openenergymonitor/emonbase/docs/rfm69-pi.md

# emonBase with RFM69Pi (ATmega328)

Version 3 of the RFM69Pi was released in 2015 and sold as part of the emonBase package until end of 2022. This product has now been replaced with the RFM69-SPI board. We do have a limited stock of the original v3 RFM69Pi board for applications that require backwards compatibility.

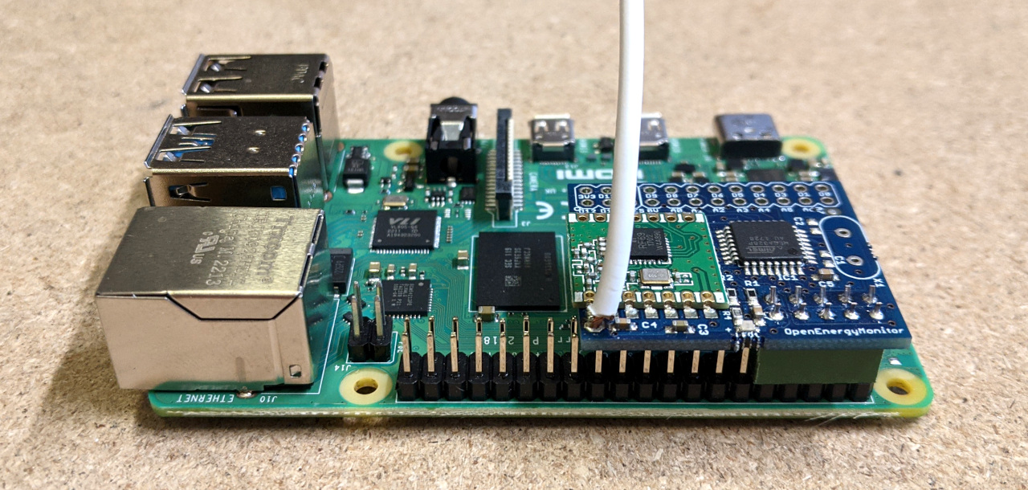
[picture p4: docs/img/emonBase_rfm69_pi.jpg]


## Using an RFM69Pi v3 with the emonTx4

If you are looking to use the new emonTx4 energy monitoring node with an existing emonBase with the RFM69Pi v3 adapter board there are a couple of options:

1\. Use the backwards compatible JeeLib Classic radio format on the emonTx4 unit. This can be selected when buying an emonTx4 form the shop.

2\. Update the firmware on the on the RFM69Pi v3 board to the LowPowerLabs compatible emonBase_rfm69pi_LPL firmware using the firmware update tool on the emonBase. Navigate to Admin > Update > Update Firmware Only. Select hardware: rfm69pi, Radio format: RFM69 LowPowerLabs.



## Firmware

- [emonBase_rfm69pi](https://github.com/openenergymonitor/RFM2Pi/tree/master/firmware/emonBase_rfm69pi): RFM69 LowPowerLabs format radio firmware (or optionally RFM69 JeeLib Native format).
- [RFM69CW_RF12_Demo_ATmega328](https://github.com/openenergymonitor/RFM2Pi/tree/master/firmware/RFM69CW_RF_Demo_ATmega328/RFM69CW_RF12_Demo_ATmega328): JeeLib Classic radio format firmware.

## EmonHub Interfacer

```
    [[RFM69PI]]
        Type = EmonHubOEMInterfacer
        [[[init_settings]]]
            com_port = /dev/ttyAMA0
            com_baud = 38400
        [[[runtimesettings]]]
            pubchannels = ToEmonCMS,
            subchannels = ToRFM12,
```

## Hardware

- [v3.1 schematic and board files](https://github.com/openenergymonitor/RFM2Pi/tree/master/hardware/RFM69Pi_V3.1)
- [v3 github documentation page](https://github.com/openenergymonitor/RFM2Pi/blob/master/docs/rfm69pi_v3.md)
