openenergymonitor/emonbase/docs/index.rst

emonBase documentation
======================

.. toctree::
   :maxdepth: 2
   
   New: RFM69-SPI (Direct) <rfm69-spi.md>
   RFM69-Pi (Atmega328) <rfm69-pi.md>
