openenergymonitor/emonbase/rfm69-spi/rfm69-spi.brd

## EAGLE design rfm69-spi/rfm69-spi.brd (2022-11-30)

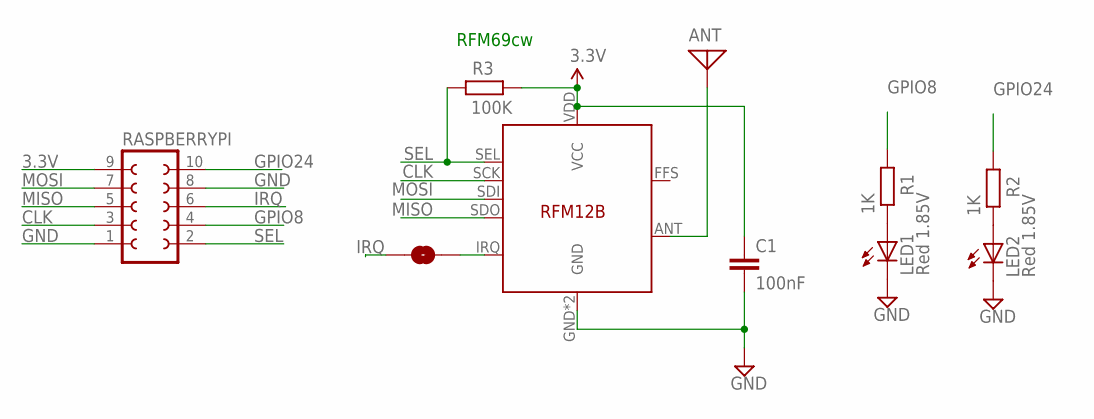
[picture p5: schematic rfm69-spi.sch]

Parts:
ANT: ANTENNA; PAD-01
C1: 100nF; C0603
GPIO15: SOLDERJUMPERNO; SJ_2S-NO
LED1, LED2: Red 1.85V; CHIP-LED0805
R1, R2: 1K; R0603
R3: 100K; R0603
RASPBERRYPI: FE05-2
U$14: RFM12B

Connections:
3.3V: C1.1, R3.1, RASPBERRYPI.9, U$14.VDD (VCC)
CLK: RASPBERRYPI.3, U$14.SCK
DIG1: ANT.1, U$14.ANT
GND: C1.2, LED1.C, LED2.C, RASPBERRYPI.1, RASPBERRYPI.8, U$14.GND, U$14.P$12 (GND)
GPIO8: R1.2, RASPBERRYPI.4
GPIO24: R2.2, RASPBERRYPI.10
IRQ: GPIO15.2, RASPBERRYPI.6
MISO: RASPBERRYPI.5, U$14.SDO
MOSI: RASPBERRYPI.7, U$14.SDI
unnamed: LED2.A, R2.1
unnamed: GPIO15.1, U$14.IRQ
unnamed: LED1.A, R1.1
SEL: R3.2, RASPBERRYPI.2, U$14.SEL

Notes on the sheet:
RFM69cw

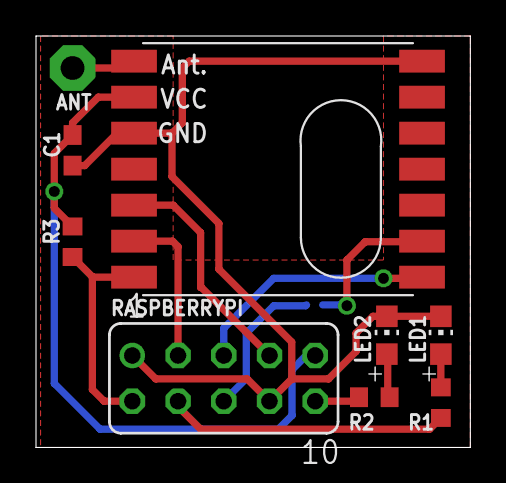
[picture p6: board rfm69-spi.brd from above]

Board: 2 copper layers, 24.1 x 22.9 mm, 10 parts (1 on the bottom side), 13 nets.
