openenergymonitor/emonbase/(commit log)

2022-11-30 rfm69-spi board files
    [rfm69-spi.brd, rfm69-spi.sch]
2022-12-01 Enable SPI docs
2024-10-21 set default selPin 26 for emonBase RFM69 SPI
